TalayKD/Arduino-Smart-Bin-CapstoneProject-Code/README.md

# Arduino-Smart-Bin-CapstoneProject-Code

Link to project description video: https://youtu.be/Ds1PBZp5xEo

For my Senior Capstone Project ("Fun Bins for Change"), I built an automated waste bin to help develop students' waste disposal habits. The waste bin stores data on each student's homeroom and whether or not the student classified waste correctly. Points are then awarded to their respective homerooms, encouraging students to dispose of waste correctly.

This is the Arduino source code for my Capstone "Fun Bins for Change" Project. Reference the [FINALIZED] CAPSTONE PROJECT file for details on what each code file does.

Source code on setting up the ESP camera in the file ESP_Try_pIC.ino was taken from https://randomnerdtutorials.com/
