TalayKD/Arduino-Smart-Bin-CapstoneProject-Code/[FINALIZED] CAPSTONE PROJECT.pdf

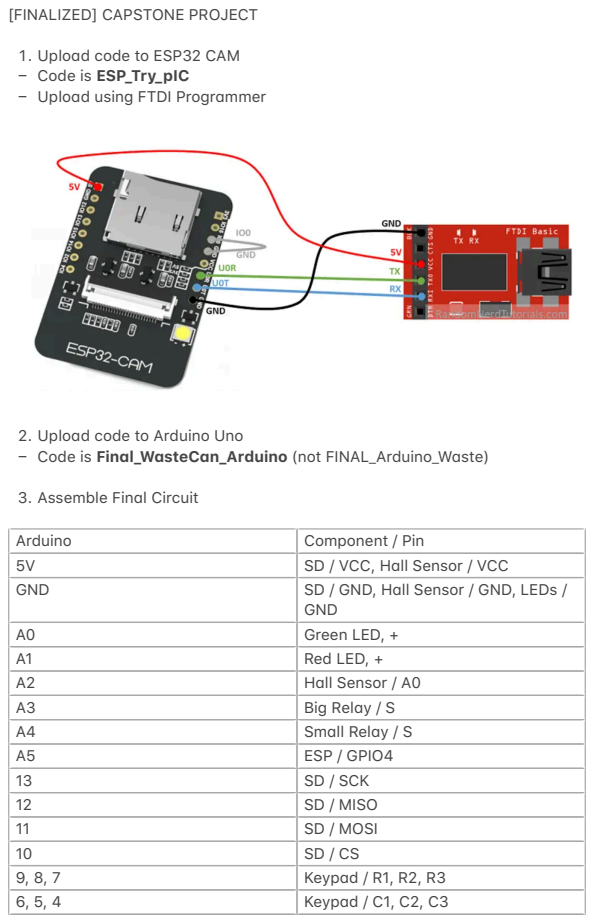
[picture p1: page 1]
Arduino; Component / Pin; SD / VCC, H<ll Sensor / VCC; GND; SD / GND, H<ll Sensor / GND, LEDs /; Green LED, +; Red LED, +; H<ll Sensor / A0; Big Rel<y / S; Sm<ll Rel<y / S; ESP / GPIO4; SD / SCK; SD / MISO; SD / MOSI; Keyp<d / R1, R2, R3; Keyp<d / C1, C2, C3

[FINALIZED] CAPSTONE PROJECT

Uplo<d code to ESP32 CAM
Code is ESP_Try_pIC
Uplo<d using FTDI Progr<mmer

Uplo<d code to Arduino Uno
Code is Fin.l_W.steC.n_Arduino (not FINAL_Arduino_W<ste)

Assemble Fin<l Circuit

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
3, 2 | ESP / Rx, Tx (connect <fter uplo<d)

Power Pins .s Norm.l
Big Rel<y / Common | Big Solenoid / +
Big Rel<y / NO | Big B<ttery / +
Big Solenoid / - | Big B<ttery / -
Sm<ll Rel<y / Common | Sm<ll Solenoid / +
Sm<ll Rel<y / NO | Sm<ll B<ttery / +
Sm<ll Solenoid / - | Sm<ll B<ttery / -

Re<dy to go:
Enter homeroom (gr<de 5 or 6): LED Red lights up <nd homeroom stored on SD C<rd
Enter w<ste type (1, 2, or 3 for Gener<l, Compost<ble, or Recycle): LED Green lights up <nd w<ste type stored on SD C<rd
Top lock unlocks
Lifts up lid <nd throws tr<sh
M<gnet detected on h<ll sensor (from lid closing)
C<mer< t<kes < picture <nd stores on SD c<rd
ESP32 sends picture number b<ck <nd stores on SD c<rd L<yer lock unlocked
B<ck to step 1
