TalayKD/Arduino-Smart-Bin-CapstoneProject-Code/Developmental Process (steps that did not work)/[CAM WORKS].pdf

!.

–
–

[CAM WORKS]

Ordering ESP32 CAM to T<ke Picture From Arduino Keyp<d

Uplo<d ESP_Try_pIC Code into ESP32 C<m using FTDI progr<mmer.

The code is b<sic<lly from https://r<ndomnerdtutori<ls.com/r<spberry-pimotion-detector-photo-c<pture/ (https://randomnerdtutorials.com/raspberry-pi-motion-detector-photo-capture/) but
del<y(200) in first line of setup esp_sleep_en<ble_ext0_w<keup(GPIO_NUM_4, 1);

The circuit is given below:

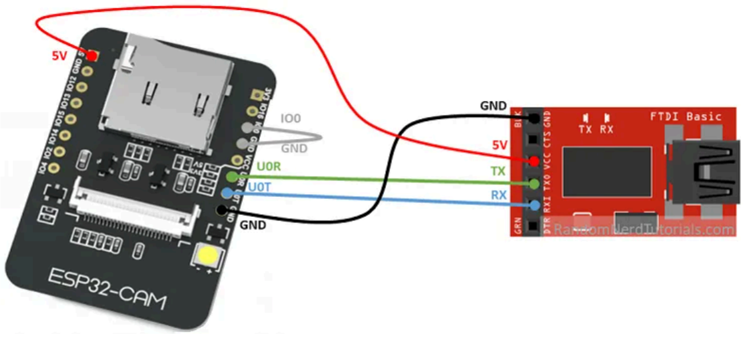
[picture p2: figure]

The bo<rd settings:

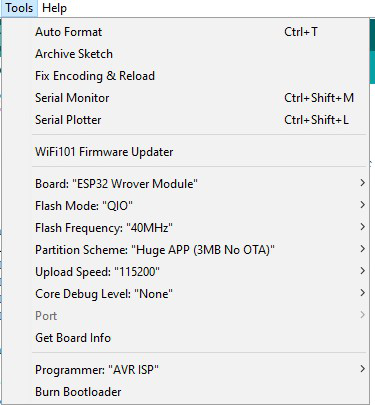
[picture p3: figure]

\.
–

].

Uplo<d code to Arduino using Arduino_StoreHomeroomPicRe<l
Lesson: pin GPIO4 is occupied for pin 13 to digit<lWrite HIGH to, but GPIO4 is <lso responsible for SD c<rd so it didnʼt work. H<d to set pin 13 (connected to GPIO4) to INPUT so it wouldnʼt send d<t< to occupy GPIO4 <nd th<t GPIO4 c<n <ccess SD c<rd, then digit<lWrite HIGH <nd it could t<ke < picture

When uplo<ding code, only keyp<d is plugged in.

Schem<tic between ESP32 - Arduino <fter code is uplo<ded

ESP32 5V - Arduino 5V
ESP32 GND - Arduino GND
ESP32 TX - Arduino RX
ESP32 RX - Arduino TX (d<t< doesnʼt re<d, it did <t first but not <nymore) *ESP32 GPIO4 - Arduino 13 (import<nt)

(the 5v <nd GND connections <re just for power, c<n use <ltern<te power source)

f. Enjoy, the picture should be t<ken when <ny key from the keyp<d is pressed.
