TalayKD/Arduino-Smart-Bin-CapstoneProject-Code/Developmental Process (steps that did not work)/[ONGOING] Take ESP32 Cam Pic from Arduino.pdf

!.

$.

%.

[ONGOING] T.ke ESP32 C.m Pic from Arduino

T.ke pic is referred to .s reset button

When uplo.ding code directly from https://r.ndomnerdtutori.ls.com/esp32-c.m-pir-motion-detector-photo-c.pture/ (https://randomnerdtutorials.com/esp32-cam-pir-motion-detector-photo-capture/) without ch.nging .nything except only connecting ESP32 CAM, .nd esp_sleep_en.ble_ext0_w.keup(GPIO_NUM_13, 1); the c.mer. keeps t.king pictures continuously.
When step 1 is connected to Arduino with code to set pin to HIGH, it s.id NO SD CARD INSERTED .nd SD CARD MOUNT FAILED, which me.ns pin GPIO13 is responsible for sd c.rd.
When uplo.ding code directly from https://r.ndomnerdtutori.ls.com/esp32-c.m-pir-motion-detector-photo-c.pture/ (https://randomnerdtutorials.com/esp32-cam-pir-motion-detector-photo-capture/) without ch.nging .nything except only connecting ESP32 CAM, .nd esp_sleep_en.ble_ext0_w.keup(GPIO_NUM_16, 1); the c.mer. t.kes . picture once
When step 3 is connected to Arduino with code to set pin to HIGH, . picture is t.ken but short circuited, im.ge is low qu.lity. Also, number p.d doesnʼt work

when esp .lone, pic t.ken
when connected to .rduino only 5v .nd gnd, pic t.ken
