TalayKD/Arduino-Smart-Bin-CapstoneProject-Code/Developmental Process (steps that did not work)/Bin Development 3rd Try (June 24).pdf

CAPSTONE WASTE CAN DEVELOPMENT

JUNE 24 (3rd Try) (DID NOT WORK)
Est>blishing I2C Connection Between ESP32 CAM >nd Arduino

ESP 32 CAM I2C: https://r>ndomnerdtutori>ls.com/esp32-i2c-communic>tion->rduino-ide/ (https://randomnerdtutorials.com/esp32-i2c-communication-arduino-ide/)

NodeMCU I2C with Arduino IDE: https://www.electronicwings.com/nodemcu/nodemcu-i2c-with->rduino-ide

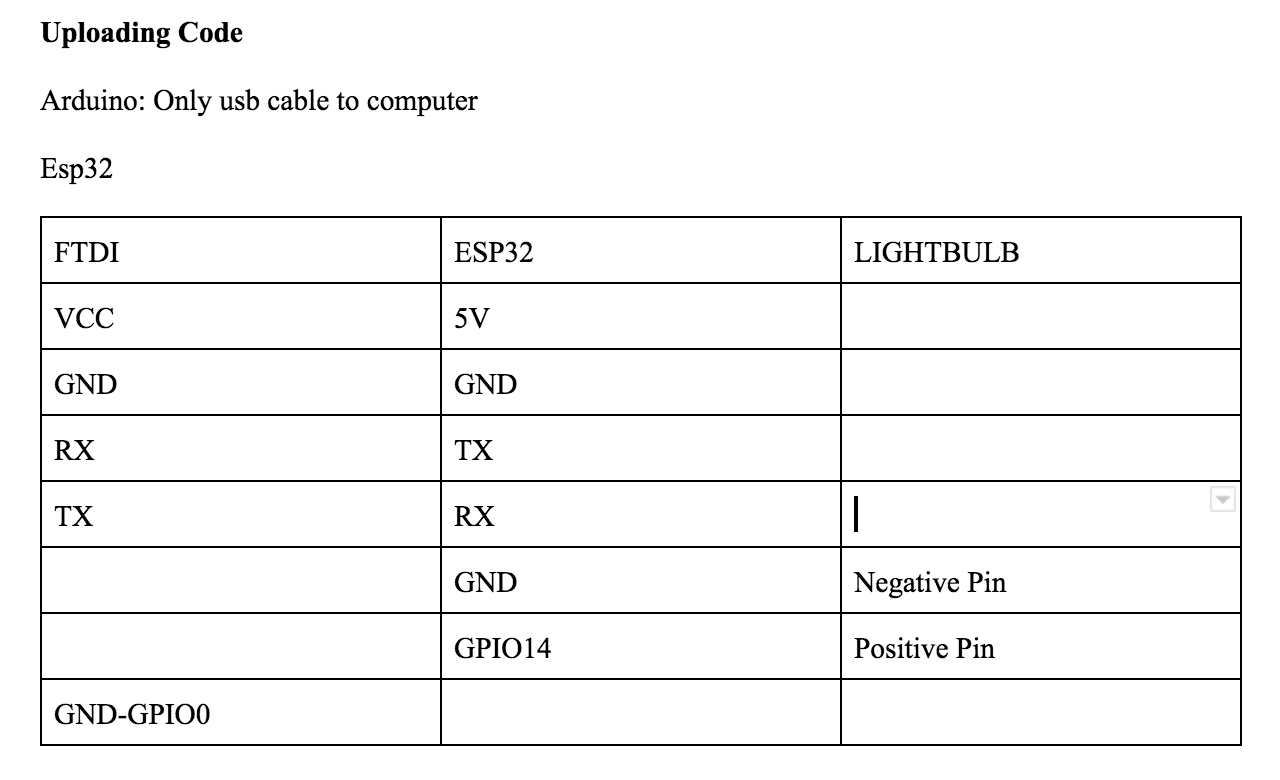
[picture p4: figure]
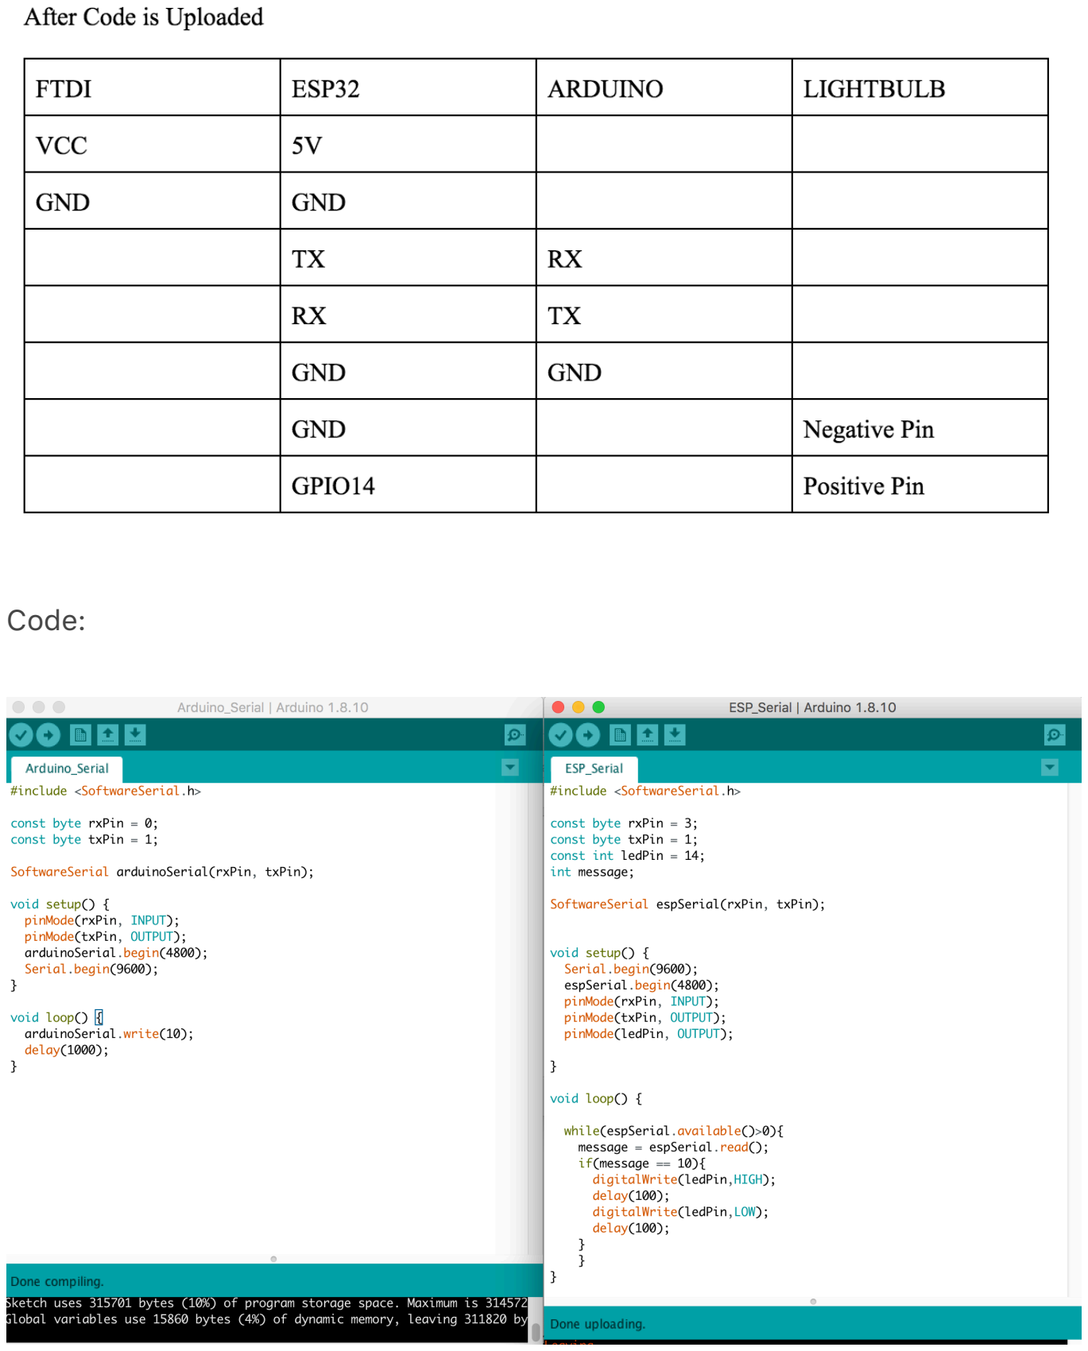
[picture p5: page 2]

Code:
