TalayKD/Arduino-Smart-Bin-CapstoneProject-Code/Developmental Process (steps that did not work)/Bin Troubleshoot Aug 2.pdf

!.

August 2, 2020

Problem: Top Solenoid Lock c>uses circuit to reset since second st>ge

Predicted c>uses:
Current from c>mer> wire c>uses m>gnetic field to interfere with h>ll sensor (?)
Solenoid lock h>s problems c>using circuit to reset, wires not given enough sp>ce, too tight (most likely)

13, 2, 4, 5

B>sic>lly the problem is th>t Arduino keeps resetting once it gets to the sm>ll solenoid lock
